blog2i2j/cyberboy666.._..recurBOY/hardware/bom/full_bom.csv

sku | qty | ref | val | vendor
A-4008 | 1 | C1 | 0.1u | tayda
A-1095 | 8 | D1 D2 D3 D4 D5 D6 D7 D8 | bat46 | tayda
A-2563 | 4 | J1 J2 J3 J4 | mono_jack_3.5mm | tayda
A-2956 | 1 | J10 | europower | tayda
https://www.aliexpress.com/item/32996979276.html | 1 | J5 | display_1.8 | other
A-196 | 1 | J6 | Pin_Socket | tayda
490-RCJ-024 | 1 | J7 | rca | mouser
A-195 | 1 | J8 | 2x20_Socket | tayda
https://www.aliexpress.com/item/4000681560472.html | 1 | J9 | push_5way | other
A-2200 | 4 | R1 R2 R3 R4 | 1K | tayda
A-5531 | 4 | RV1 RV2 RV3 RV4 | 10k_pot | tayda
A-4812 | 5 | SW1 SW2 SW3 SW4 SW5 | push | tayda
A-2470 | 1 | U1 | mcp3008 | tayda
https://www.aliexpress.com/item/1005004990907467.html | 1 | - | sd_card | aliexpress
https://www.aliexpress.com/item/1005002962792811.html | 1 | - | otg_adapter | aliexpress
- | 2 | - | m3x25mm_screws | anywhere
- | 2 | - | m3_nuts | anywhere
A-003 | 1 | - | dip16_socket | tayda
A-198 | 1 | - | 2x20_pin_header | tayda
A-4815 | 5 | - | A25_tact_caps_12mm | tayda
https://www.aliexpress.com/item/32810107963.html | 1 | - | A11_tact_cap_5way | aliexpress
