blog2i2j/cyberboy666.._..recurBOY/hardware/recurBOY.pdf

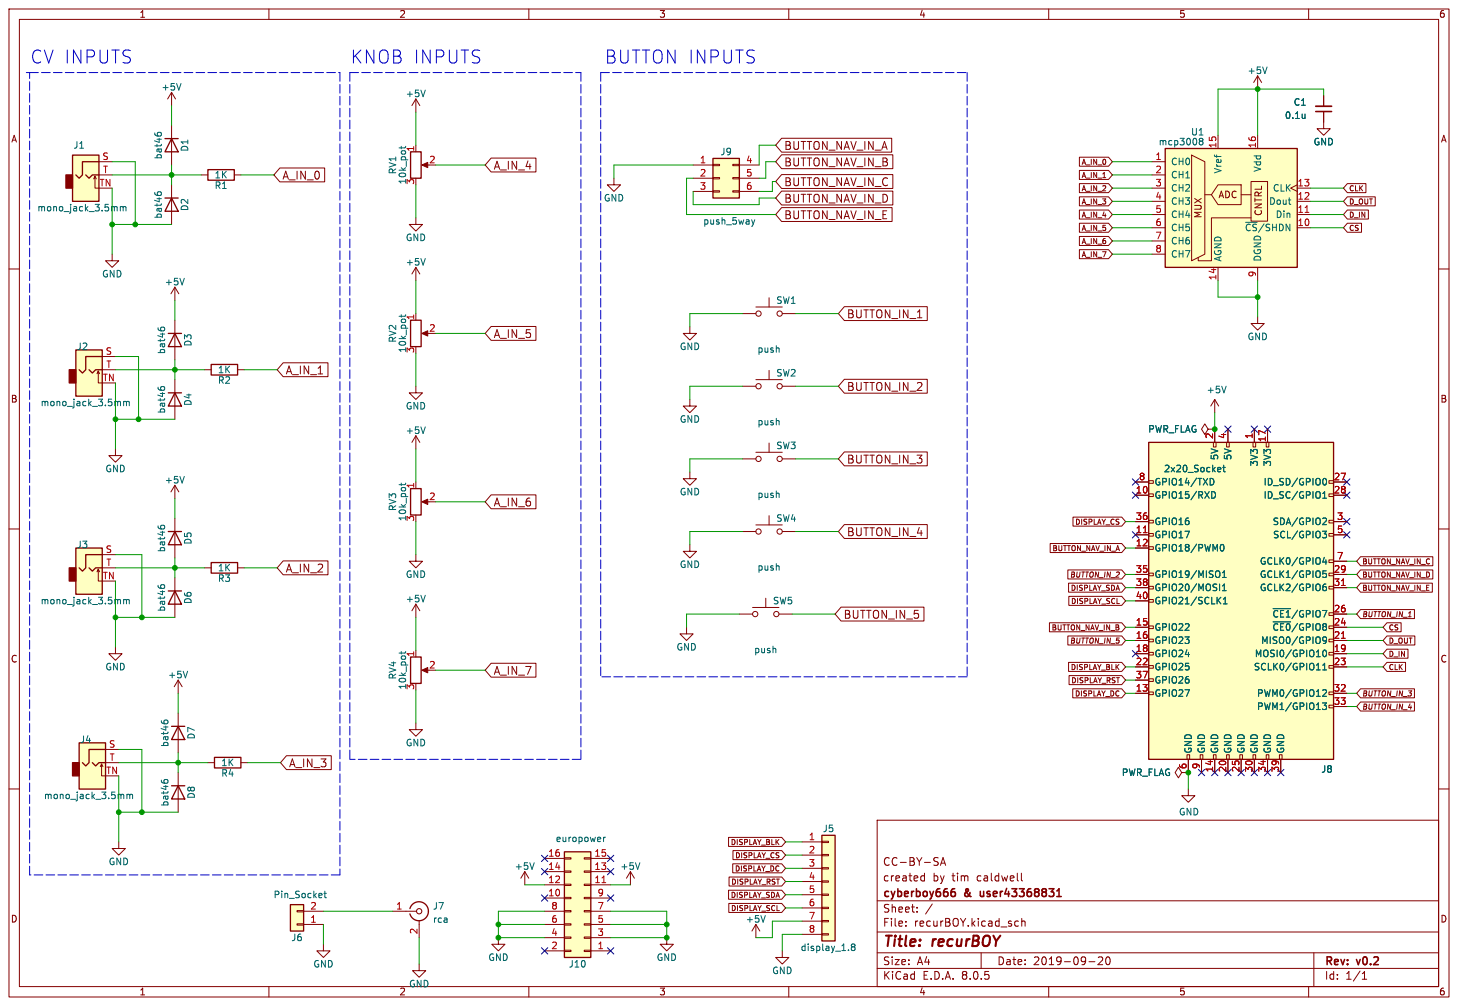
[picture p1: page 1]
