blog2i2j/cyberboy666.._..recurBOY/(commit log)

2025-04-04 update board to v1_0_0h
    [default_panel-B_Cu.gbr, default_panel-B_Mask.gbr, default_panel-B_Paste.gbr, default_panel-B_Silkscreen.gbr, default_panel-Edge_Cuts.gbr, default_panel-F_Cu.gbr, default_panel-F_Mask.gbr, default_panel-F_Paste.gbr]
2025-05-08 update hardware to v1_1_0 plus small panel updates
    [eurorack_panel-B_Cu.gbr, eurorack_panel-B_Mask.gbr, eurorack_panel-B_Paste.gbr, eurorack_panel-B_Silkscreen.gbr, eurorack_panel-Edge_Cuts.gbr, eurorack_panel-F_Cu.gbr, eurorack_panel-F_Mask.gbr, eurorack_panel-F_Paste.gbr]
2026-01-15 tidy up panel stuff
    [eurorack_panel-B_Cu.gbr, eurorack_panel-B_Mask.gbr, eurorack_panel-B_Paste.gbr, eurorack_panel-B_Silkscreen.gbr, eurorack_panel-Edge_Cuts.gbr, eurorack_panel-F_Cu.gbr, eurorack_panel-F_Mask.gbr, eurorack_panel-F_Paste.gbr]
2026-01-15 connect tft backlight pin to rpi gpio25
    [recurBOY-B_Cu.gbl, recurBOY-B_Mask.gbs, recurBOY-B_Silkscreen.gbo, recurBOY-Edge_Cuts.gm1, recurBOY-F_Cu.gtl, recurBOY-F_Mask.gts, recurBOY-F_Silkscreen.gto, recurBOY-NPTH.drl]
