blog2i2j/cyberboy666.._..recurBOY/(notices)

Notices in the files:
hardware/recurBOY.kicad_sch:
CC-BY-SA
